iic-jku/ihp-sg13cmos5l-ams-chip-template/release/v.1.0.0/netlist/schematic/README.md

# Schematic Netlists

Schematic netlists of `chip_top` for LVS, exported from Xschem.

They are written by `make klayout-lvs-netlist` (CDL, `chip_top_klayout.cdl`) and by `make magic-lvs-netlist` (SPICE, `chip_top_magic.spice`). Both targets also run as the first step of `make klayout-lvs` and `make magic-lvs`.

This folder stays empty until the top-level LVS is finished. See [Layout Versus Schematic (LVS)](https://github.com/iic-jku/ihp-sg13cmos5l-ams-chip-template/blob/main/README.md#layout-versus-schematic-lvs) in the top-level README.
