iic-jku/ihp-sg13cmos5l-ams-chip-template/macros/counter/render/img/counter_top_librelane.png

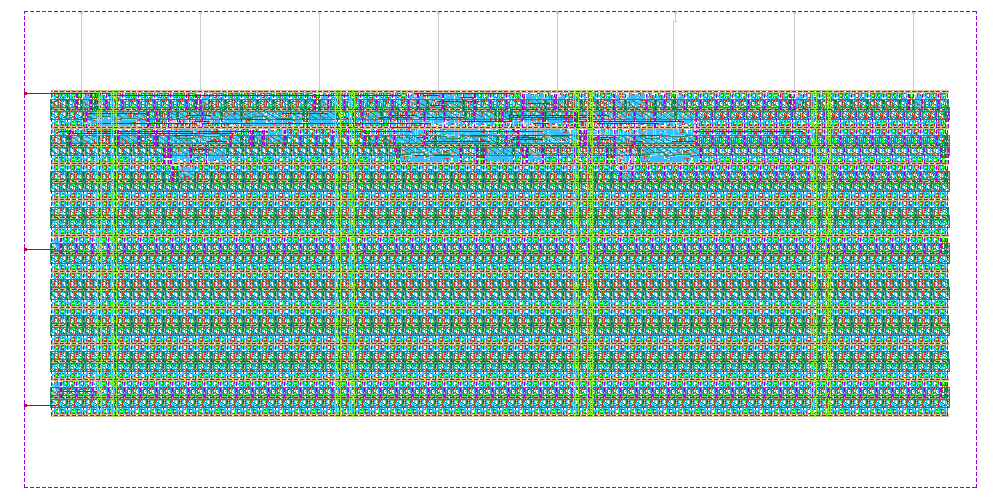
macros/counter/render/img/counter_top_librelane.png
