iic-jku/ihp-sg13cmos5l-ams-chip-template/macros/inverter/render/img/inverter_top_black.png

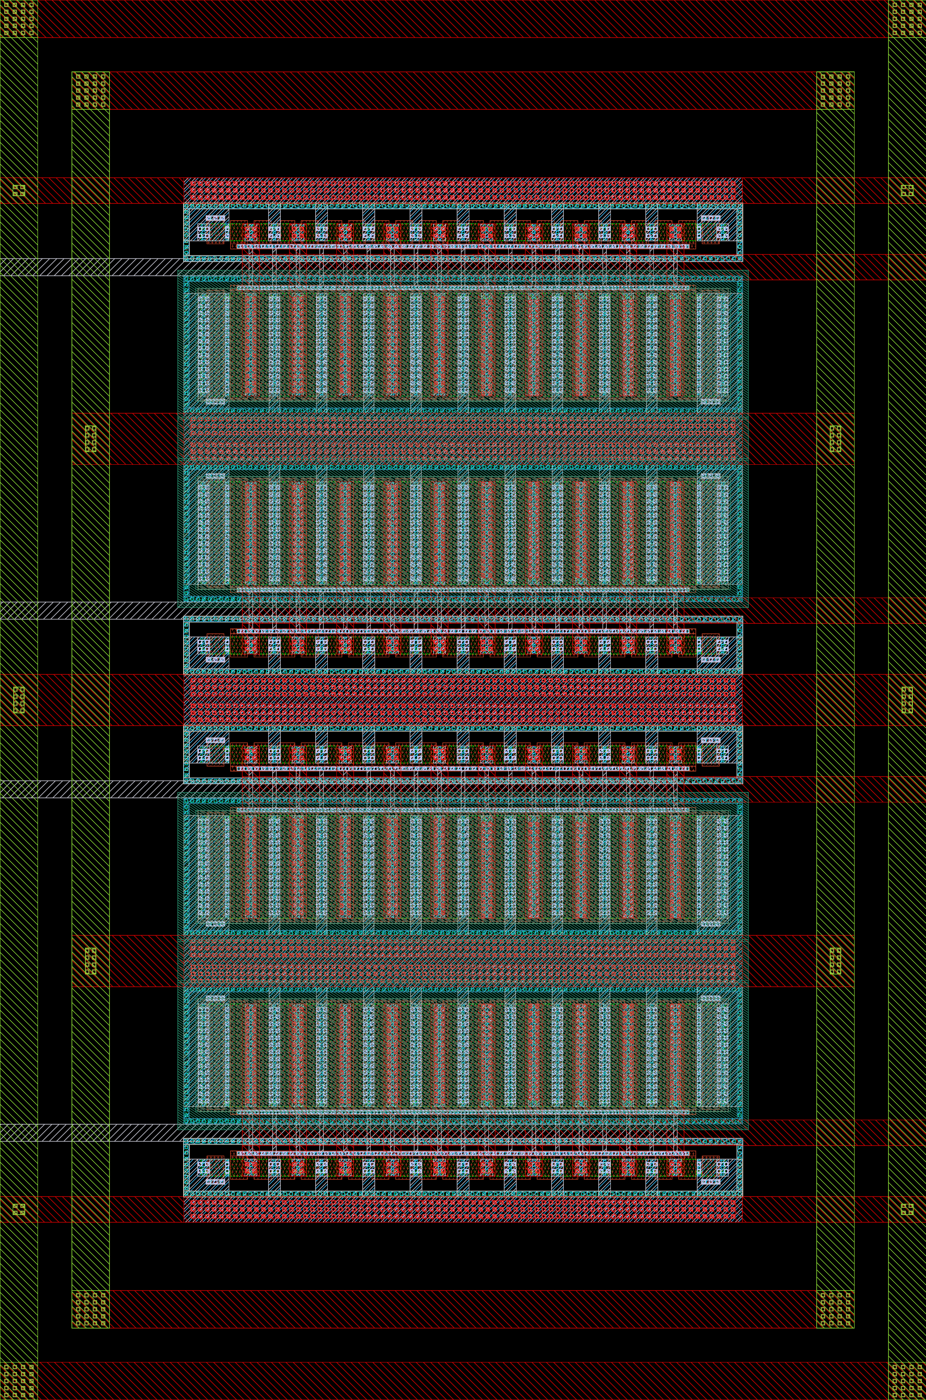
macros/inverter/render/img/inverter_top_black.png
