iic-jku/ihp-sg13cmos5l-ams-chip-template/packaging/render/chip_top_bondplan_black.png

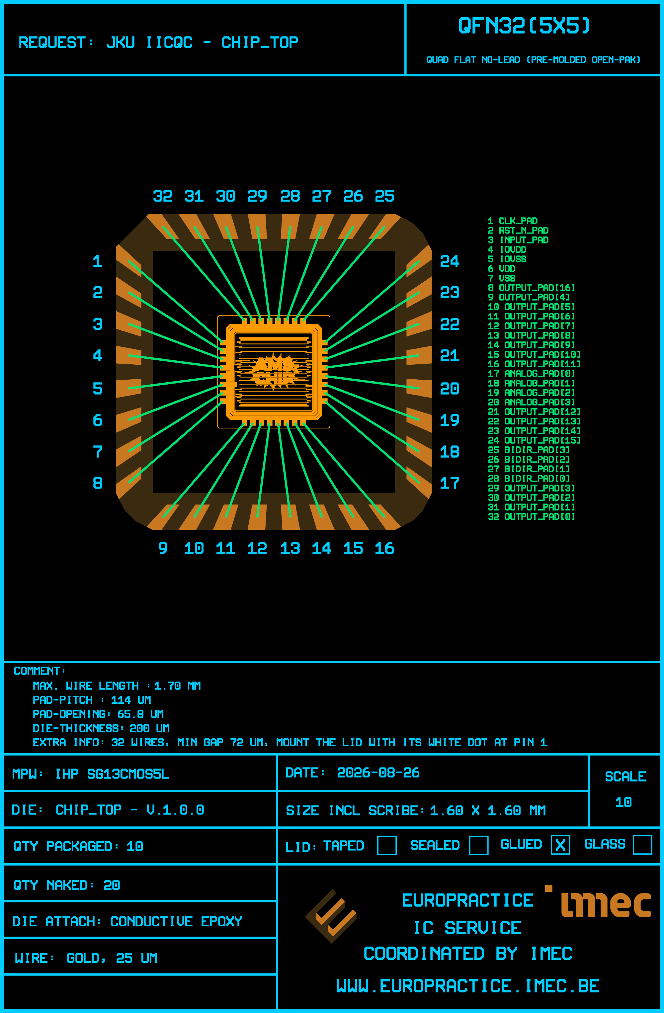
packaging/render/chip_top_bondplan_black.png
