iic-jku/ihp-sg13cmos5l-ams-chip-template/macros/inverter/testbenches/xschem/plot_simulations/figures/inverter_tb_ac_ol.csv

frequency | Aol_dB | Aol_arg
1.000000000000000056e-01 | 3.132881599999999978e+01 | 1.799999980000000050e+02
1.046651209999999999e-01 | 3.132881599999999978e+01 | 1.799999980000000050e+02
1.095478760000000024e-01 | 3.132881599999999978e+01 | 1.799999980000000050e+02
1.146584169999999986e-01 | 3.132881599999999978e+01 | 1.799999980000000050e+02
1.200073710000000016e-01 | 3.132881599999999978e+01 | 1.799999980000000050e+02
1.256058600000000136e-01 | 3.132881599999999978e+01 | 1.799999980000000050e+02
1.314655249999999997e-01 | 3.132881599999999978e+01 | 1.799999970000000076e+02
1.375985510000000134e-01 | 3.132881599999999978e+01 | 1.799999970000000076e+02
1.440176900000000038e-01 | 3.132881599999999978e+01 | 1.799999970000000076e+02
1.507362899999999950e-01 | 3.132881599999999978e+01 | 1.799999970000000076e+02
1.577683199999999897e-01 | 3.132881599999999978e+01 | 1.799999970000000076e+02
1.651284040000000064e-01 | 3.132881599999999978e+01 | 1.799999970000000076e+02
1.728318440000000122e-01 | 3.132881599999999978e+01 | 1.799999970000000076e+02
1.808946580000000137e-01 | 3.132881599999999978e+01 | 1.799999960000000101e+02
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
