iic-jku/ihp-sg13cmos5l-ams-chip-template/testbenches/xschem/plot_simulations/figures/chip_top_tb_tran_analog_inv.pdf

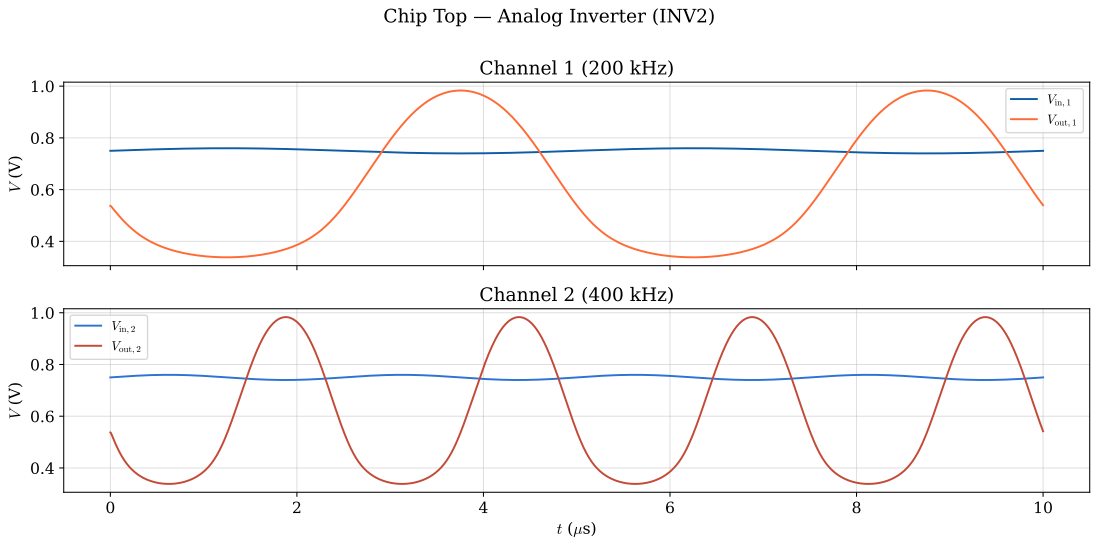
[picture p62: page 1]
Channel 1 (200 kHz); Channel 2 (400 kHz); Chip Top; — Analog Inverter (INV2)
