iic-jku/ihp-sg13cmos5l-ams-chip-template/testbenches/xschem/plot_simulations/figures/chip_top_tb_tran_digital1.pdf

# Chip Top

# — Digital Inverter Outputs (INV1)

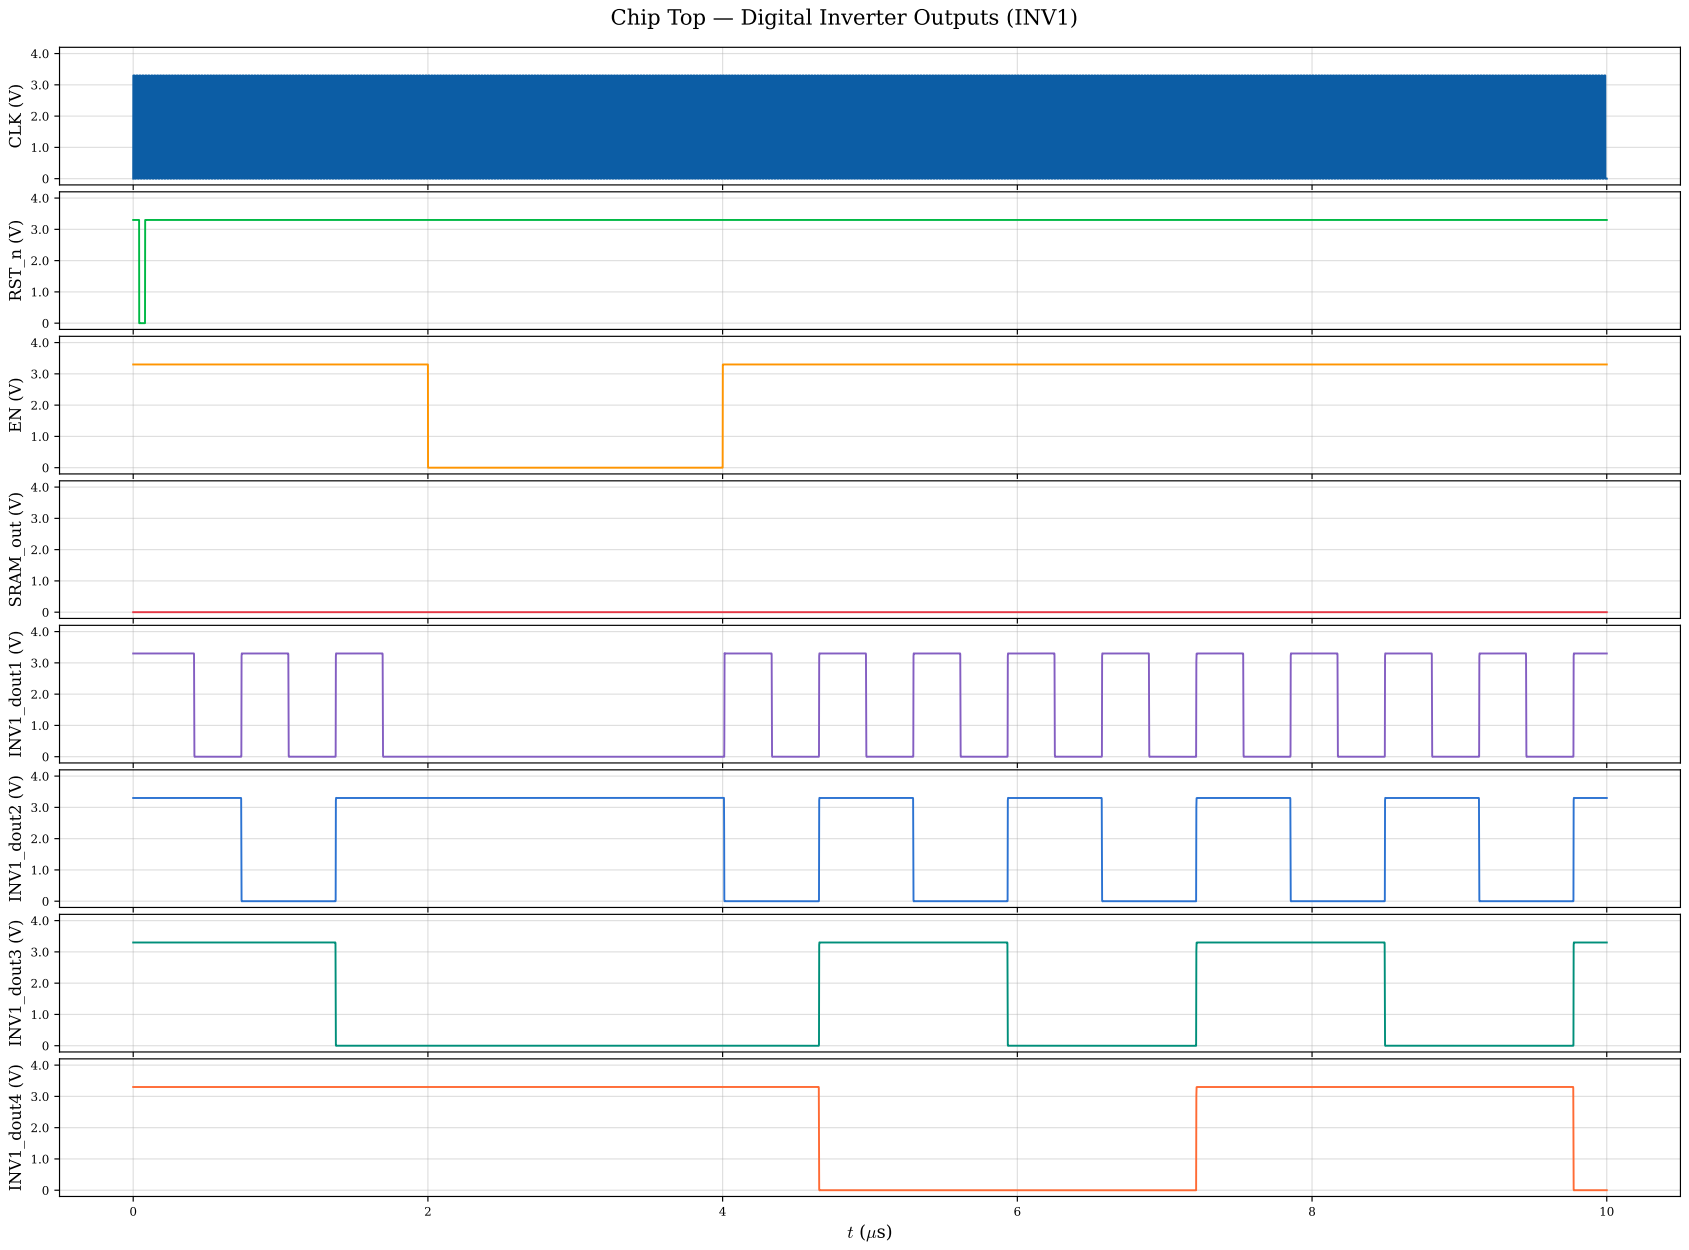
[picture p63: page 1]
CLK (V); RST_n (V); SRAM_out (V); INV1_dout1 (V); INV1_dout2 (V); INV1_dout3 (V); INV1_dout4 (V)
