iic-jku/ihp-sg13cmos5l-ams-chip-template/testbenches/xschem/plot_simulations/figures/chip_top_tb_tran_digital2.pdf

# Chip Top

# — Counter 2 Output Bits

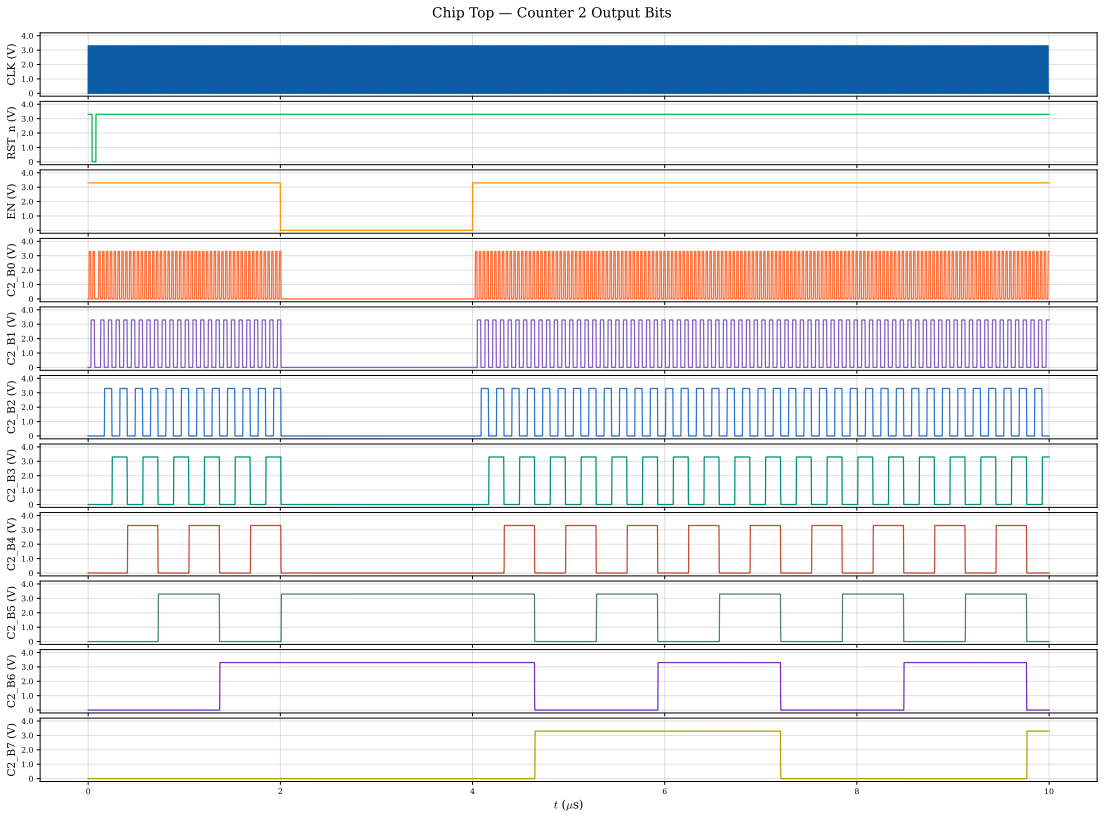
[picture p64: page 1]
CLK (V); RST_n (V)
