iic-jku/ihp-sg13cmos5l-ams-chip-template/macros/counter/testbenches/xschem/plot_simulations/figures/counter_top_tb_tran.pdf

# Counter Top - Gate-Level Transient Simulation

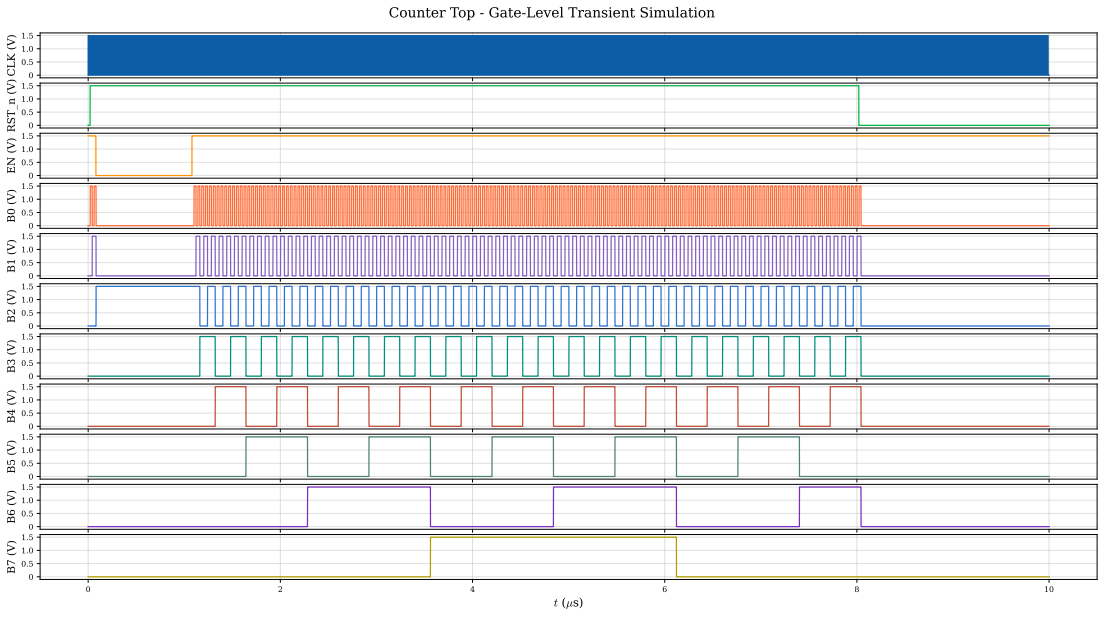
[picture p66: page 1]
CLK (V); RST_n (V)
