iic-jku/ihp-sg13cmos5l-ams-chip-template/macros/inverter/testbenches/xschem/plot_simulations/figures/inverter_top_tb_tran.pdf

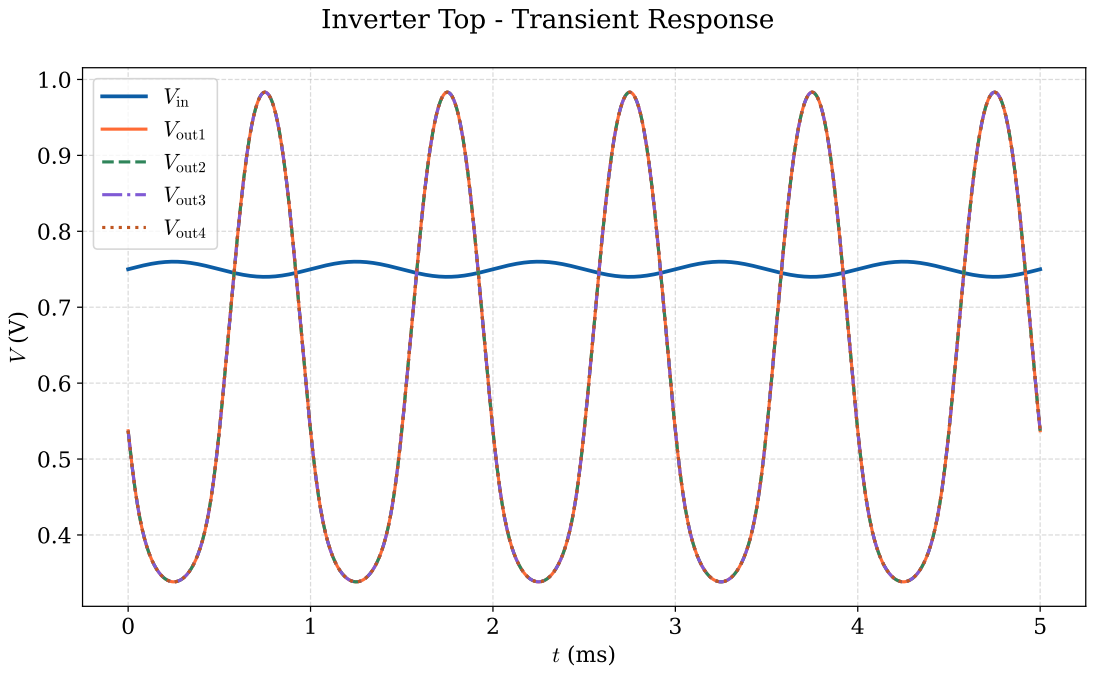
[picture p68: page 1]

Inverter Top - Transient Response

Vin Vout1

Vout2 Vout3 Vout4
