iic-jku/ihp-sg13cmos5l-ams-chip-template/macros/inverter/netlist/pex/inverter_top_magic_pex_3.spice

* PEX produced on Wed Aug 26 09:49:16 AM CEST 2026 using /foss/tools/sak/sak-pex.sh with m=3 and s=1 (extresist threshold=10000 mOhm, minres=1000 mOhm, mindelay=1 ps)
* NGSPICE file created from inverter_top_pex.ext - technology: ihp-sg13cmos5l

.subckt inverter_top_pex VDD vin4 vout4 VSS vin3 vout3 vin2 vout2 vout1 vin1
X0 vout4 vin4 VDD VDD sg13_lv_pmos ad=1.14p pd=6.38u as=1.14p ps=6.38u w=6u l=1u
X1 VDD vin2 vout2 VDD sg13_lv_pmos ad=1.14p pd=6.38u as=1.14p ps=6.38u w=6u l=1u
X2 VSS.t119 vin2 vout2 VSS.t43 sg13_lv_nmos ad=0.19p pd=1.38u as=0.19p ps=1.38u w=1u l=1u
X3 vout2 vin2 VSS.t121 VSS.t48 sg13_lv_nmos ad=0.19p pd=1.38u as=0.19p ps=1.38u w=1u l=1u
X4 vout2 vin2 VDD VDD sg13_lv_pmos ad=1.14p pd=6.38u as=1.14p ps=6.38u w=6u l=1u
X5 VSS.t87 vin4 vout4 VSS.t86 sg13_lv_nmos ad=0.19p pd=1.38u as=0.19p ps=1.38u w=1u l=1u
X6 vout1 vin1 VSS.t24 VSS.t25 sg13_lv_nmos ad=0.19p pd=1.38u as=0.19p ps=1.38u w=1u l=1u
X7 VDD vin2 vout2 VDD sg13_lv_pmos ad=1.14p pd=6.38u as=1.14p ps=6.38u w=6u l=1u
X8 vout4 vin4 VSS.t59 VSS.t79 sg13_lv_nmos ad=0.19p pd=1.38u as=0.19p ps=1.38u w=1u l=1u
X9 VDD vin2 vout2 VDD sg13_lv_pmos ad=1.14p pd=6.38u as=1.14p ps=6.38u w=6u l=1u
X10 VSS.t53 vin3 vout3 VSS.t52 sg13_lv_nmos ad=0.19p pd=1.38u as=0.19p ps=1.38u w=1u l=1u
X11 vout4 vin4 VSS.t96 VSS.t97 sg13_lv_nmos ad=0.19p pd=1.38u as=0.19p ps=1.38u w=1u l=1u
X12 VDD vin3 vout3 VDD sg13_lv_pmos ad=1.14p pd=6.38u as=1.14p ps=6.38u w=6u l=1u
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
R472 VSS.n177 VSS.n111 0.0901212
R473 VSS.n206 VSS.n205 0.0897551
R474 VSS.t93 VSS.n113 0.0891211
R475 VSS.t93 VSS.n208 0.0889922
R476 VSS.n195 VSS.n194 0.0884223
R477 VSS.n116 VSS.n175 0.0878849
R478 VSS.n180 VSS.n169 0.0878849
R479 VSS.t15 VSS.n116 0.0876767
R480 VSS.n181 VSS.n180 0.0876767
R481 VSS.n194 VSS.n193 0.0871182
R482 VSS.n208 VSS.n207 0.0865477
R483 VSS.n193 VSS.n113 0.0864162
R484 VSS.n207 VSS.n206 0.0857922
R485 VSS.n181 VSS.n111 0.0854405
R486 VSS.n175 VSS.n174 0.0852323
R487 VSS.n176 VSS.n169 0.0852323
R488 VSS.n65 VSS.t76 0.0849321
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
