iic-jku/ihp-sg13cmos5l-ams-chip-template/macros/counter/netlist/spice/counter_top.spice

* NGSPICE file created from counter_top.ext - technology: ihp-sg13cmos5l

* Black-box entry subcircuit for sg13cmos5l_decap_8 abstract view
.subckt sg13cmos5l_decap_8 VDD VSS
.ends

* Black-box entry subcircuit for sg13cmos5l_dfrbpq_1 abstract view
.subckt sg13cmos5l_dfrbpq_1 Q CLK D RESET_B VDD VSS
.ends

* Black-box entry subcircuit for sg13cmos5l_a21oi_1 abstract view
.subckt sg13cmos5l_a21oi_1 Y A1 A2 B1 VDD VSS
.ends

* Black-box entry subcircuit for sg13cmos5l_dlygate4sd3_1 abstract view
.subckt sg13cmos5l_dlygate4sd3_1 X A VDD VSS
.ends

* Black-box entry subcircuit for sg13cmos5l_fill_1 abstract view
.subckt sg13cmos5l_fill_1 VDD VSS
.ends

* Black-box entry subcircuit for sg13cmos5l_buf_1 abstract view
.subckt sg13cmos5l_buf_1 X A VDD VSS
.ends

* Black-box entry subcircuit for sg13cmos5l_and2_1 abstract view
.subckt sg13cmos5l_and2_1 X A B VDD VSS
.ends

* Black-box entry subcircuit for sg13cmos5l_or3_1 abstract view
.subckt sg13cmos5l_or3_1 X A B C VDD VSS
.ends

* Black-box entry subcircuit for sg13cmos5l_decap_4 abstract view
.subckt sg13cmos5l_decap_4 VDD VSS
.ends

* Black-box entry subcircuit for sg13cmos5l_fill_2 abstract view
.subckt sg13cmos5l_fill_2 VDD VSS
.ends

* Black-box entry subcircuit for sg13cmos5l_xnor2_1 abstract view
.subckt sg13cmos5l_xnor2_1 Y A B VDD VSS
.ends

* Black-box entry subcircuit for sg13cmos5l_o21ai_1 abstract view
.subckt sg13cmos5l_o21ai_1 Y A1 A2 B1 VDD VSS
.ends

* Black-box entry subcircuit for sg13cmos5l_nand3_1 abstract view
.subckt sg13cmos5l_nand3_1 Y A B C VDD VSS
.ends

* Black-box entry subcircuit for sg13cmos5l_nand2_1 abstract view
.subckt sg13cmos5l_nand2_1 Y A B VDD VSS
.ends

* Black-box entry subcircuit for sg13cmos5l_tiehi abstract view
.subckt sg13cmos5l_tiehi L_HI VDD VSS
.ends

* Black-box entry subcircuit for sg13cmos5l_nor2_1 abstract view
.subckt sg13cmos5l_nor2_1 Y A B VDD VSS
.ends

* Black-box entry subcircuit for sg13cmos5l_buf_4 abstract view
.subckt sg13cmos5l_buf_4 X A VDD VSS
.ends

* Black-box entry subcircuit for sg13cmos5l_buf_8 abstract view
.subckt sg13cmos5l_buf_8 X A VDD VSS
.ends

* Black-box entry subcircuit for sg13cmos5l_xor2_1 abstract view
.subckt sg13cmos5l_xor2_1 X A B VDD VSS
.ends

* Black-box entry subcircuit for sg13cmos5l_nand4_1 abstract view
.subckt sg13cmos5l_nand4_1 Y A B C D VDD VSS
.ends

* Black-box entry subcircuit for sg13cmos5l_inv_1 abstract view
.subckt sg13cmos5l_inv_1 Y A VDD VSS
.ends

.subckt counter_top VDD VSS clock_i counter_value_o[0] counter_value_o[1] counter_value_o[2]
+ counter_value_o[3] counter_value_o[4] counter_value_o[5] counter_value_o[6] counter_value_o[7]
+ enable_i reset_n_i
XFILLER_7_7 VDD VSS sg13cmos5l_decap_8
XFILLER_13_133 VDD VSS sg13cmos5l_decap_8
XFILLER_9_137 VDD VSS sg13cmos5l_decap_8
XFILLER_3_56 VDD VSS sg13cmos5l_decap_8
XFILLER_5_343 VDD VSS sg13cmos5l_decap_8
XFILLER_12_98 VDD VSS sg13cmos5l_decap_8
XFILLER_12_21 VDD VSS sg13cmos5l_decap_8
XFILLER_10_147 VDD VSS sg13cmos5l_decap_8
XFILLER_2_357 VDD VSS sg13cmos5l_decap_8
XFILLER_17_291 VDD VSS sg13cmos5l_decap_8
X_66_ _66_/Q _73_/CLK _66_/D _66__18/L_HI VDD VSS sg13cmos5l_dfrbpq_1
XFILLER_5_140 VDD VSS sg13cmos5l_decap_8
XFILLER_9_88 VDD VSS sg13cmos5l_decap_8
XFILLER_9_11 VDD VSS sg13cmos5l_decap_8
XFILLER_0_35 VDD VSS sg13cmos5l_decap_8
XFILLER_2_154 VDD VSS sg13cmos5l_decap_8
X_49_ _49_/Y _49_/A1 _48_/X _42_/A VDD VSS sg13cmos5l_a21oi_1
XFILLER_11_231 VDD VSS sg13cmos5l_decap_8
XFILLER_7_224 VDD VSS sg13cmos5l_decap_8
Xhold30 _45_/A1 _43_/Y VDD VSS sg13cmos5l_dlygate4sd3_1
XFILLER_16_345 VDD VSS sg13cmos5l_decap_8
XFILLER_4_238 VDD VSS sg13cmos5l_decap_8
XFILLER_6_56 VDD VSS sg13cmos5l_decap_8
XFILLER_15_87 VDD VSS sg13cmos5l_fill_1
XFILLER_15_21 VDD VSS sg13cmos5l_decap_8
XFILLER_13_359 VDD VSS sg13cmos5l_decap_8
XFILLER_9_319 VDD VSS sg13cmos5l_decap_8
Xoutput7 counter_value_o[4] _73_/Q VDD VSS sg13cmos5l_buf_1
XFILLER_8_385 VDD VSS sg13cmos5l_decap_8
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
XFILLER_14_333 VDD VSS sg13cmos5l_decap_8
XFILLER_2_259 VDD VSS sg13cmos5l_decap_8
X_54_ _56_/C _54_/A _66_/Q _73_/Q _72_/Q VDD VSS sg13cmos5l_nand4_1
XFILLER_1_270 VDD VSS sg13cmos5l_decap_8
XFILLER_2_21 VDD VSS sg13cmos5l_decap_8
XFILLER_2_98 VDD VSS sg13cmos5l_decap_8
XFILLER_11_336 VDD VSS sg13cmos5l_decap_8
XFILLER_7_329 VDD VSS sg13cmos5l_decap_8
XFILLER_11_63 VDD VSS sg13cmos5l_decap_8
X_37_ _42_/A _65_/A VDD VSS sg13cmos5l_inv_1
XFILLER_11_133 VDD VSS sg13cmos5l_decap_8
XFILLER_7_126 VDD VSS sg13cmos5l_decap_8
XFILLER_0_0 VDD VSS sg13cmos5l_decap_8
XFILLER_3_343 VDD VSS sg13cmos5l_decap_8
XFILLER_8_42 VDD VSS sg13cmos5l_decap_8
XFILLER_16_225 VDD VSS sg13cmos5l_decap_4
XFILLER_0_357 VDD VSS sg13cmos5l_decap_8
XFILLER_3_140 VDD VSS sg13cmos5l_decap_8
XFILLER_13_217 VDD VSS sg13cmos5l_decap_8
XFILLER_12_294 VDD VSS sg13cmos5l_decap_8
XFILLER_8_287 VDD VSS sg13cmos5l_decap_8
XFILLER_8_210 VDD VSS sg13cmos5l_decap_8
XFILLER_0_154 VDD VSS sg13cmos5l_decap_8
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
