iic-jku/ihp-sg13cmos5l-ams-chip-template/macros/counter/final/pnl/counter_top.pnl.v

module counter_top (clock_i,
    enable_i,
    reset_n_i,
    VDD,
    VSS,
    counter_value_o);
 input clock_i;
 input enable_i;
 input reset_n_i;
 inout VDD;
 inout VSS;
 output [7:0] counter_value_o;

 wire _00_;
 wire _01_;
 wire _02_;
 wire _03_;
 wire _04_;
 wire _05_;
 wire _06_;
 wire _07_;
 wire _08_;
 wire _09_;
 wire _10_;
 wire _11_;
 wire _12_;
 wire _13_;
 wire _14_;
 wire _15_;
 wire _16_;
 wire _17_;
 wire _18_;
 wire _19_;
 wire _20_;
 wire _21_;
 wire _22_;
 wire _23_;
 wire _24_;
 wire _25_;
 wire _26_;
 wire _27_;
 wire _28_;
 wire net12;
 wire net13;
 wire net14;
 wire net15;
 wire net16;
 wire net17;
 wire net18;
 wire clknet_0_clock_i;
 wire net3;
 wire net4;
 wire net5;
 wire net6;
 wire net7;
 wire net8;
 wire net9;
 wire net10;
 wire net1;
 wire net2;
 wire net11;
 wire net;
 wire clknet_1_0__leaf_clock_i;
 wire clknet_1_1__leaf_clock_i;
 wire net19;
 wire net20;
 wire net21;
 wire net22;
 wire net23;
 wire net24;
 wire net25;
 wire net26;
 wire net27;
 wire net28;
 wire net29;
 wire net30;
 wire net31;
 wire net32;
 wire net33;
 wire net34;
 wire net35;
 wire net36;

 sg13cmos5l_decap_8 FILLER_0_0 (.VDD(VDD),
    .VSS(VSS));
 sg13cmos5l_decap_8 FILLER_0_105 (.VDD(VDD),
    .VSS(VSS));
 sg13cmos5l_decap_8 FILLER_0_112 (.VDD(VDD),
    .VSS(VSS));
 sg13cmos5l_decap_8 FILLER_0_119 (.VDD(VDD),
    .VSS(VSS));
 sg13cmos5l_decap_8 FILLER_0_126 (.VDD(VDD),
    .VSS(VSS));
 sg13cmos5l_decap_8 FILLER_0_133 (.VDD(VDD),
    .VSS(VSS));
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
 sg13cmos5l_buf_1 output7 (.A(net7),
    .X(counter_value_o[4]),
    .VDD(VDD),
    .VSS(VSS));
 sg13cmos5l_buf_1 output8 (.A(net8),
    .X(counter_value_o[5]),
    .VDD(VDD),
    .VSS(VSS));
 sg13cmos5l_buf_1 output9 (.A(net9),
    .X(counter_value_o[6]),
    .VDD(VDD),
    .VSS(VSS));
endmodule
