iic-jku/ihp-sg13cmos5l-ams-chip-template/ip/sg13cmos5l_io_custom/verilog/sg13cmos5l_io.v

// Copyright 2024 IHP PDK Authors
//
// Licensed under the Apache License, Version 2.0 (the "License");
// you may not use this file except in compliance with the License.
// You may obtain a copy of the License at
//
//    https://www.apache.org/licenses/LICENSE-2.0
//
// Unless required by applicable law or agreed to in writing, software
// distributed under the License is distributed on an "AS IS" BASIS,
// WITHOUT WARRANTIES OR CONDITIONS OF ANY KIND, either express or implied.
// See the License for the specific language governing permissions and
// limitations under the License.

// type: Corner
`timescale 1ns/10ps
`celldefine
module sg13cmos5l_Corner (iovdd, iovss, vdd, vss);
	inout iovdd;
	inout iovss;
	inout vdd;
	inout vss;
endmodule
`endcelldefine

// type: Filler200
`timescale 1ns/10ps
`celldefine
module sg13cmos5l_Filler200 (iovdd, iovss, vdd, vss);
	inout iovdd;
	inout iovss;
	inout vdd;
	inout vss;
endmodule
`endcelldefine

// type: Filler400
`timescale 1ns/10ps
`celldefine
module sg13cmos5l_Filler400 (iovdd, iovss, vdd, vss);
	inout iovdd;
	inout iovss;
	inout vdd;
	inout vss;
endmodule
`endcelldefine

// type: Filler1000
`timescale 1ns/10ps
`celldefine
module sg13cmos5l_Filler1000 (iovdd, iovss, vdd, vss);
	inout iovdd;
	inout iovss;
	inout vdd;
	inout vss;
endmodule
`endcelldefine

// type: Filler2000
`timescale 1ns/10ps
`celldefine
module sg13cmos5l_Filler2000 (iovdd, iovss, vdd, vss);
	inout iovdd;
	inout iovss;
	inout vdd;
	inout vss;
endmodule
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
	inout iovss;
	inout vdd;
	inout vss;
	inout pad;
	inout padres;
	inout padbare;

	// Function
	assign pad = padres;
	assign padres = pad;

	assign pad = padbare;
	assign padbare = pad;

	// Timing
	specify
		(pad => padres) = 0;
		(padres => pad) = 0;
	endspecify
endmodule
`endcelldefine

// type: IOVss
`timescale 1ns/10ps
`celldefine
module sg13cmos5l_IOPadIOVss (iovdd, iovss, vdd, vss);
	inout iovdd;
	inout iovss;
	inout vdd;
	inout vss;
endmodule
`endcelldefine

// type: IOVdd
`timescale 1ns/10ps
`celldefine
module sg13cmos5l_IOPadIOVdd (iovdd, iovss, vdd, vss);
	inout iovdd;
	inout iovss;
	inout vdd;
	inout vss;
endmodule
`endcelldefine

// type: Vss
`timescale 1ns/10ps
`celldefine
module sg13cmos5l_IOPadVss (iovdd, iovss, vdd, vss);
	inout iovdd;
	inout iovss;
	inout vdd;
	inout vss;
endmodule
`endcelldefine

// type: Vdd
`timescale 1ns/10ps
`celldefine
module sg13cmos5l_IOPadVdd (iovdd, iovss, vdd, vss);
	inout iovdd;
	inout iovss;
	inout vdd;
	inout vss;
endmodule
`endcelldefine
