iic-jku/ihp-sg13cmos5l-ams-chip-template/(commit log)

2026-07-31 initial commit of `macros` folder
    [counter_top_tb_tran.csv, counter_top_tb_tran.sch, inverter.sch, inverter_tb_ac.csv, inverter_tb_ac.sch, inverter_tb_ac_ol.csv, inverter_tb_ac_ol.sch, inverter_tb_dc_vout.csv]
2026-07-31 ported counter to `ihp-sg13cmos5l`
    [counter_top_tb_tran.sch]
2026-07-31 ported inverter to `ihp-sg13cmos5l`
    [inverter_tb_ac.sch, inverter_tb_ac_ol.sch, inverter_tb_dc_vout.sch, inverter_tb_tran.sch, inverter_top_tb_tran.sch]
2026-08-24 synced `macros` with the G2 template (`next_release` 9672308)
    Replaced `macros/` with the current G2 tree and re-applied the CMOS5L adaptations on top: the sg13g2 to sg13cmos5l rename in the 16 hand-maintained files, cornerHBT and cornerCAP removed from the testbench corner blocks, `corner_c` removed from the CACE datasheet, `klayout-pex` commented out of `klayout-verify` with README warnings (kpex has no CMOS5L support), and the Metal4 and KLayout streamout notes in the counter config.
    Removed the `sg13cmos5l_pr` xschemrc append, the 2026.08 PDK adds the path itself (ToDo item).
    Kept the CMOS5L inverter layouts and the renamed sizing data, which is byte-identical to G2, and added the missin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
    [counter_top_tb_tran.sch, inverter.sch, inverter_tb_ac_ol.sch, inverter_tb_dc_vout.sch, inverter_tb_tran.sch, inverter_top_tb_tran.sch]
2026-08-24 added the PR boundary guard to the inverter (synced with G2)
    Added `check-boundary` (`scripts/check_boundary.py`) and run it first in `build-top`, so a top-cell layout without a shape on the PR boundary layer 189 fails the macro build instead of the chip flow. The README documents the rule. Script, target and README section are identical to the G2 template.
2026-08-24 added the `ip` folder (bondpad, logos, IO library snapshot) ported from the G2 template
    Copied the three IP blocks from the G2 template and adapted them to the CMOS5L stack (Metal1 to Metal4 plus TopMetal1).
    The bondpad uses the CMOS5L `SG13_dev` bondpad PCell, whose top metal is fixed to TopMetal1 and whose bottom metal ranges from 1 to 4, and its LEF exposes `pad` on Metal2 to TopMetal1 with `sg13cmos5l_ioSite`.
    The logos are drawn on Metal4, the top thin metal, instead of Metal5.
    Reworked `img2lay.py`: layer names are resolved through the PDK's KLayout layer properties instead of a table in the Makefile, `--block-size` scales the image so that the GDS boundary and the LEF SIZE always agre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
    [sg13cmos5l_io.v]
2026-08-25 added the GitHub Actions workflows and REUSE licensing ported from the G2 template
    license-check.yml and quarto-publish.yml are byte-identical to ihp-sg13g2-ams-chip-template @ b7cd9e7. regression.yml differs in two lines, the PDK env variable and its comment: the container setup script honours a pre-set PDK and already maps ihp-sg13cmos5l to sg13cmos5l_stdcell, so no further adaptation is needed.
    LICENSES/ holds the same four license texts as G2. REUSE.toml keeps G2's 19 annotation blocks and changes three paths: the IO library name, the logo GDS on TopMetal1 instead of TopMetal2, and the dropped counter_top.asc/.bin/.json entries, which match nothing since the FPGA outputs moved to <board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
2026-08-25 added the `tutorial` folder (ported and adapted from the G2 template)
    Ported tutorial/ from ihp-sg13g2-ams-chip-template @ d8d7b95 (next_release) and adapted it for SG13CMOS5L.
    Text follows the CMOS5L stack: no Metal5/TopMetal2/HBTs, PDN on Metal4 and TopMetal1 with each inverter ring on Metal4 only, magic-pex as the PEX path because KPEX has no CMOS5L support yet, bondpad bottom metal 1 to 4 with top fixed to TopMetal1, logos on Metal4, and the SG13CMOS5L PDK KLayout menu for the GUI DRC/LVS steps.
    Data-driven figures (chip renders, plot SVGs, CACE plots, JKU logo) come from this repo's build outputs, the four inverter testbench schematics were re-exported from the CMOS5L schematics, and ta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
2026-08-25 added the `doc` folder (ported and adapted from the G2 template)
    Ported doc/ from ihp-sg13g2-ams-chip-template @ b7cd9e7 (next_release), where doc/ is identical on main and next_release, and adapted it for SG13CMOS5L. The 20 files fall into four groups.
    Copied verbatim because they carry no PDK content: the four ihp-structure-proposals layouts and the two Verilog cheatsheet PDFs. The gen_structure.py that produced the proposals stays untracked, as in G2.
    Taken from the PDK itself rather than from the G2 repo, renamed to lower case to match the folder convention: sg13cmos5l_os_layout_rules.pdf (Rev. 0.1, 2025-12-08) and sg13cmos5l_os_process_spec.pdf (Rev. 0.2, 2025-12-15), both byte-identi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
    [sg13cmos5l_os_layout_cheatsheet.xlsx]
2026-08-25 added `flow/` folder
2026-08-25 added `schematic/` folder
    [chip_top.sch]
2026-08-25 added `testbenches/` folder
    [chip_top_tb_tran.csv, chip_top_tb_tran.sch]
2026-08-25 updated `chip_top_tb_tran.sch`
    [chip_top_tb_tran.sch]
2026-08-25 fixed the duplicate VSS pin that broke the PEX pin reorder
    `chip_top.sch` labelled both ground pads VSS, so `chip_top.sym` carried the pin name twice and `sak-pin-reorder.py` aborted with a pin count mismatch of 32 against 31. A `.subckt` port list holds one entry per net, so the same name cannot appear twice.
    The IO ground pad `x8` (`sg13cmos5l_IOPadIOVss`), its supply ring and the matching symbol pin are now labelled IOVSS, which is what `chip_top.sv`, the LibreLane netlist `netlist/spice/chip_top.spice` and the pin labels of the GDS have called it all along. The ring assignment was checked geometrically before the rename: the ring at x=540 carries the `iovss` pin of all 32 pads, the one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
    [chip_top.sch]
2026-08-25 updated top-level schematics
    [chip_top_tb_tran.sch]
2026-08-25 kept the full pad ring visible on the PEX symbol
    `symbol-pex` deleted the merged supply pin and its text label, so the generated `<CELL>_pex.sym` lost part of the pinout it is meant to show. Only the pin box carries connectivity, the label is drawing, so the label stays and `IOVSS` is still readable on the PEX symbol next to the pin box that is gone.
    The pin dropping moved out of the make recipe into [`scripts/prune_pex_symbol.py`](scripts/prune_pex_symbol.py), which also drops every repeat of a pin name after the first. A chip that draws one pin per bond pad puts several pins of the same name on its symbol, and a `.subckt` port list holds one entry per net, so the pads that share a supply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
2026-08-26 [Server] executed magic-pex, all and release targets
    [chip_top_tb_tran.sch]
2026-09-04 expanded the analog macro tutorial with the HeiChips workshop hands-on content
    Ports the SG13G2 change of the same name (ihp-sg13g2-ams-chip-template edf1bc7) to this template. The HeiChips 2026 analog workshop (https://heichips.github.io/heichips26-analog-workshop/) was written for this PDK and explains the manual steps in much more detail, so its hands-on content lands in the analog macro section, adapted to the files here.
    New: the inverter circuit figure with its dummy devices, a Getting Started with Xschem section with the shortcut table, an Anatomy of the AC Testbench walk-through covering the spice_ignore spares, the model includes, the control block, the measurements and the FET .sa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
2026-09-04 fixed the tutorial figure pre-conversion, whose glob reached no figure at all
    The `fig-pdf` helper globbed `fig/*.svg` while every figure lives one level deeper in a per-topic subfolder, so it converted nothing, `make clean`'s `rm -f fig/*.pdf` deleted nothing, and the PDF render died in the Quarto Lua filter on exactly the rsvg-convert defect the helper exists to work around. It stayed hidden because it only fires on Windows: CI installs librsvg2-bin and lets Quarto convert the figures itself.
    Both loops now recurse with `find`, and both skip figure PDFs that git tracks. `targets_overview.pdf` and `tools_overview.pdf` are draw.io exports committed next to their SVG, so a recursive conversi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
2026-10-12 corrected the DRC level table in `README.md` and the tutorial
    The table described generic checks instead of what `sak-drc.sh` passes to the PDK's `run_drc.py`. For the IHP Open-PDK, `precheck` runs the foundry precheck rule set, `macro` adds the full FEOL and BEOL rules with off-grid, angle and recommended rules, and `regular` adds density, the extra rules and antenna. `run_drc.py` adds the pin checks at every level, and the PDK has no zero-area check. The README also names the flags of each level.
2026-10-17 added the macro sizing procedure to the LibreLane hardening section of the tutorial
    Ported from ihp-sg13g2-ams-chip-template. The die-size limits, synthesis areas and slack figures of the counter come from test runs on this PDK, not from G2.
