iic-jku/ihp-sg13cmos5l-ams-chip-template/(notices)

Notices in the files:
README.md:
License: Solderpad Hardware License v2.1
